jhoel507-afk/solarcleanerpro/docs/conexionado/LEEME.md

# Conexionado final

`conexionado_final.png` (para ver) y `conexionado_final.svg` (editable): alimentación de 220 V con el hongo, salida de 12 V, control de 5 V, ESP32 con todos sus pines y la caja de mando.
