jhoel507-afk/solarcleanerpro/docs/MARCA_Y_AUTORIA.md

# Marca y autoría de SolarCleanerPro

**Titulares (autores):** Leon Mena, Ángel Joel · Gallegos Valencia, Cristian Augusto

## Situación actual
- El nombre y el logotipo se usan con **™** (marca en uso). El símbolo **®** solo se puede usar cuando INDECOPI otorgue el registro; antes de eso no debe usarse.
- El software, los diagramas y los manuales llevan el aviso **© 2026** con los nombres de los autores (ya está en la app, el programa del ESP32, el README y `LICENSE.txt`).
- El registro de marca **no se hace desde el proyecto**: lo presentan los titulares ante INDECOPI. Esta carpeta deja preparado lo necesario.

## Qué se puede registrar
| Elemento | Tipo | Archivo |
|---|---|---|
| Nombre «SolarCleanerPro» | Marca denominativa | — |
| Nombre + logotipo | Marca mixta (recomendada) | `docs/marca/logo.png`, `logo.svg` |
| Software, manual y diagramas | Derecho de autor (registro de obra, declarativo) | `www/`, `esp32/`, `docs/` |

## Clases de Niza sugeridas (verificar la redacción exacta en la lista de INDECOPI)
- **Clase 7:** máquinas y aparatos para limpieza (limpieza automática de paneles solares).
- **Clase 9:** software y aplicaciones descargables; aparatos de control.
- **Clase 37:** servicios de limpieza y mantenimiento de paneles solares.

La tasa se paga por clase, así que conviene empezar por la clase principal y ampliar después.

## Pasos
1. **Buscar antecedentes** en INDECOPI (búsqueda de marcas) para ver si ya existe un nombre igual o parecido en las mismas clases. Es lo primero, antes de pagar.
2. **Pagar la tasa** de cada clase (Págalo.pe u otro medio indicado por INDECOPI).
3. **Presentar la solicitud en línea** (plataforma SEL de INDECOPI) o en mesa de partes, con los datos de los titulares, el signo, el logotipo y los productos o servicios.
4. **Examen de forma** y publicación en la Gaceta Electrónica de Propiedad Industrial; plazo para oposiciones de terceros.
5. **Examen de fondo** y resolución. Si hay observaciones, responder dentro del plazo (si no, el expediente se abandona y se pierde la tasa).
6. **Certificado de registro**, con vigencia de 10 años renovables.

## Datos que hay que reunir
- Nombres completos, DNI, domicilio y correo de los dos titulares (copropiedad de la marca).
- Logotipo en alta resolución (`docs/marca/logo.png`).
- Lista de productos y servicios por clase.
- Si hay RUC activo y registro REMYPE de una empresa, existe un descuento en la tasa; para dos personas naturales normalmente no aplica.

## Riesgos y recomendaciones
- **Nombre descriptivo.** «Solar Cleaner» significa limpiador solar, y los nombres que solo describen el producto suelen rechazarse o quedar como registro débil. Registrar el nombre **junto con el logotipo** ayuda; si se quiere una protección fuerte, conviene sumar un elemento propio y distintivo al nombre.
- **Institución.** El proyecto se desarrolló en SENATI. Antes de registrar, revisen el reglamento de propiedad intelectual del instituto y, si usaron recursos o asesoría de la institución, conseguir por escrito la conformidad o el acuerdo de titularidad.
- **Coautoría.** Dejar por escrito cómo se reparten los derechos entre los dos titulares (por ejemplo, 50 % y 50 %) y quién decide sobre licencias o venta.
- **Fechas.** Guardar copias fechadas del código, los diagramas y el informe (el repositorio de GitHub sirve como evidencia de autoría).
- Para un asesoramiento definitivo, consultar a un abogado de propiedad intelectual o a la oficina de INDECOPI.
