jhoel507-afk/solarcleanerpro/docs/conexionado/conexionado_final.png

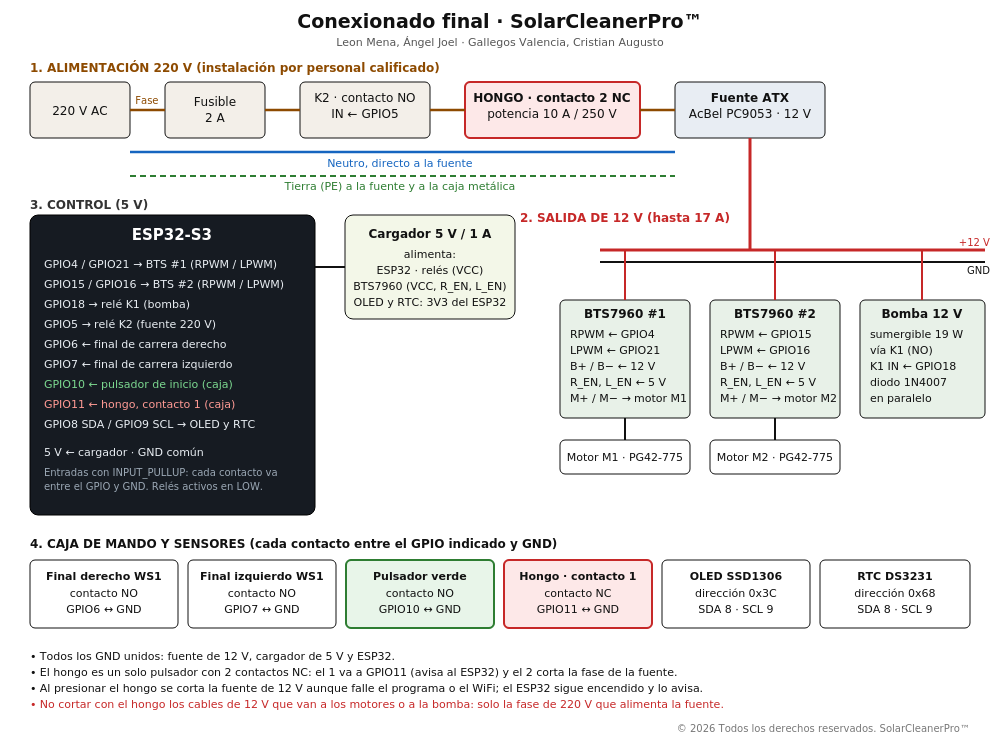
docs/conexionado/conexionado_final.png
