jhoel507-afk/solarcleanerpro/CHANGELOG.md

# Historial de cambios

## 2.18.0
- Conexionado final (PNG y SVG) con el hongo cortando la fase de 220 V; archivo `.ino` integrado.

## 2.17.0
- Compatibilidad con el programa original: pestaña `Estado_API` (estado en JSON, pulsador de inicio y lectura del hongo), comandos y programación con las rutas originales, parámetros en el formato del código original y valores por defecto iguales a sus constantes.

## 2.16.0
- Manual de usuario, historial de cambios y pruebas automáticas (`npm test`).

## 2.15.0
- Hoja de datos protegida con PIN y copia de seguridad.

## 2.14.0
- Hoja de datos aparte (como una hoja de cálculo): todas las entradas en un solo lugar; las demás hojas solo muestran resultados.

## 2.13.0
- Formatos de la guía del proyecto: tablas 4.1 y 4.2, costo total, especificaciones por bloques y selección con IB ≤ In ≤ IZ.

## 2.12.0
- Lista de materiales y retorno de la inversión editables, con escenarios.

## 2.11.0
- Boquillas fijas (una por panel) como disposición por defecto, con opción de boquilla en el carro. Autoría, marca y licencia.

## 2.9.0 a 2.10.0
- Alineación con el informe: datos del motor, la fuente y la bomba; programación horaria con reloj DS3231; pantalla OLED; página web servida por el ESP32 con portal cautivo; generador de texto para el informe.

## 2.6.0 a 2.8.0
- Hongo de emergencia y pulsador de inicio; parámetros del ciclo editables; diagrama en pantalla completa; rediseño sobrio.

## 2.0.0 a 2.5.0
- Aplicación para Android y Windows con simulación, hojas de mecanismo y conexionado, cálculos de agua y vida útil, conexión automática por WiFi propio y programa del ESP32.
