jhoel507-afk/solarcleanerpro/esp32/SolarCleanerPro_ESP32/pagina_web.h

// Generado por tools/generar_pagina.py. No editar a mano.
#pragma once
#include <Arduino.h>

const size_t PAGINA_GZ_LEN = 47640;
const uint8_t PAGINA_GZ[] PROGMEM = {
  0x1f, 0x8b, 0x08, 0x00, 0x00, 0x00, 0x00, 0x00, 0x02, 0x03, 0xd4, 0xbd, 0x5d, 0x73, 0xdb, 0x48,
  0x92, 0x28, 0xfa, 0xee, 0x5f, 0x81, 0xa6, 0x77, 0x9a, 0xa4, 0x45, 0x52, 0xf8, 0x26, 0x48, 0x59,
  0xea, 0x23, 0xcb, 0x72, 0x5b, 0x3b, 0xb2, 0xa4, 0xb1, 0xdc, 0xf2, 0xce, 0xf4, 0xf6, 0x76, 0x80,
  0x00, 0x48, 0xa1, 0x0d, 0x12, 0x6c, 0x80, 0x94, 0x64, 0x6b, 0x14, 0xb1, 0x37, 0xe2, 0xc4, 0x8d,
  0xf3, 0x7c, 0xf6, 0x61, 0x23, 0xee, 0xdb, 0xec, 0xc3, 0x8d, 0xd8, 0x87, 0x79, 0xb8, 0x31, 0x71,
  0xe2, 0x44, 0xec, 0xe3, 0xfa, 0x9f, 0xcc, 0x2f, 0x39, 0x99, 0x55, 0x05, 0xa0, 0xf0, 0x45, 0x91,
  0x20, 0xec, 0xd9, 0xdb, 0x1f, 0x22, 0x3e, 0xaa, 0x32, 0xb3, 0xb2, 0xb2, 0x32, 0xb3, 0xb2, 0xb2,
  0x0a, 0xcf, 0xbf, 0x79, 0x79, 0x7e, 0xf4, 0xee, 0xf7, 0x17, 0xc7, 0xc2, 0xf5, 0x62, 0xea, 0x1d,
  0x3c, 0xc7, 0xbf, 0x82, 0x67, 0xce, 0x26, 0xfb, 0x0d, 0x27, 0x6c, 0x08, 0xb6, 0xb9, 0x30, 0xbb,
  0x8b, 0x6b, 0x67, 0xea, 0xec, 0x37, 0x6c, 0x33, 0xf8, 0xd0, 0x80, 0x12, 0x8e, 0x69, 0x1f, 0x3c,
  0x9f, 0x3a, 0x0b, 0x53, 0xb0, 0xae, 0xcd, 0x20, 0x74, 0x16, 0xfb, 0x8d, 0xe5, 0x62, 0xdc, 0x35,
  0x1a, 0xec, 0xe9, 0xcc, 0xc4, 0xd2, 0x37, 0xae, 0x73, 0x3b, 0xf7, 0x83, 0x45, 0x43, 0xb0, 0xfc,
  0xd9, 0xc2, 0x99, 0x41, 0xa9, 0x5b, 0xd7, 0x5e, 0x5c, 0xef, 0xdb, 0xce, 0x8d, 0x6b, 0x39, 0x5d,
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
  0x73, 0xec, 0x74, 0xcd, 0xc0, 0x31, 0xa1, 0x51, 0x30, 0x98, 0xf1, 0x65, 0x47, 0x9c, 0xdf, 0xb5,
  0x85, 0x1d, 0xa1, 0x8f, 0xbf, 0x0f, 0x4f, 0x46, 0xbe, 0xfd, 0xf1, 0x7e, 0x6a, 0x06, 0x13, 0x77,
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
};
